Ahmed-Samy-Elsaiid/Mechanical-Absorber/README.md

# Mechanical-Absorber
Designing mechanical absorber to nullify the vibration in the system.
