Ahmed-Samy-Elsaiid/Mechanical-Absorber/MV Project Final.pdf

# REPORT

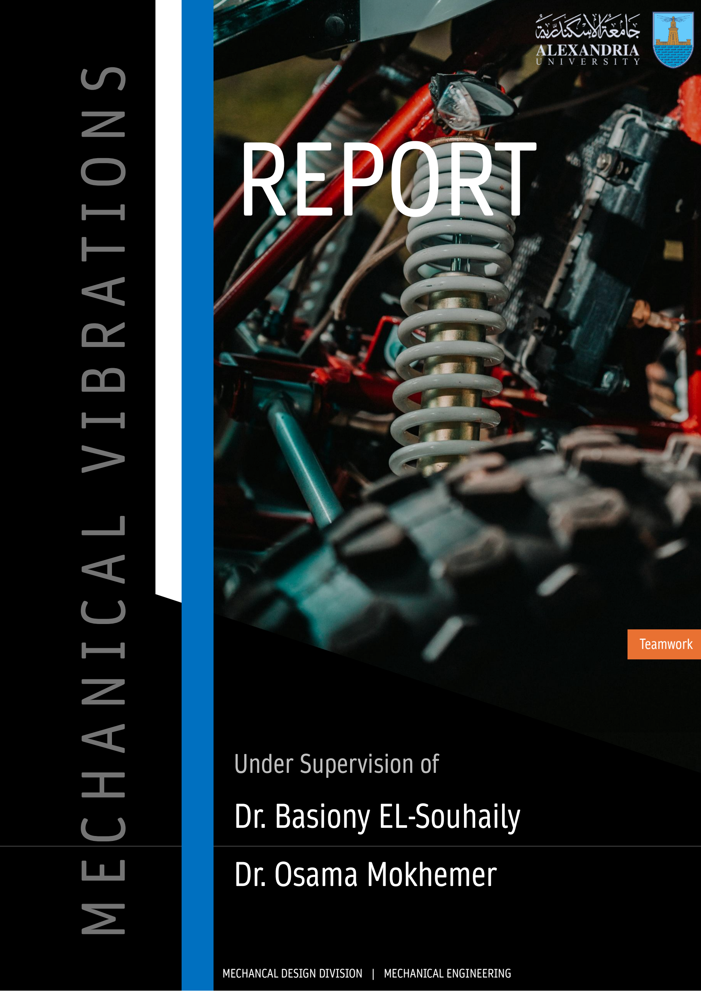
[picture p1: page 1]

## Under Supervision of

# Dr. Basiony EL

# -Souhaily

# Dr. Osama Mokhemer

# M E C H A N I C A L V I B R A T I O N S

MECHANCAL DESIGN DIVISION | MECHANICAL ENGINEERING

Teamwork

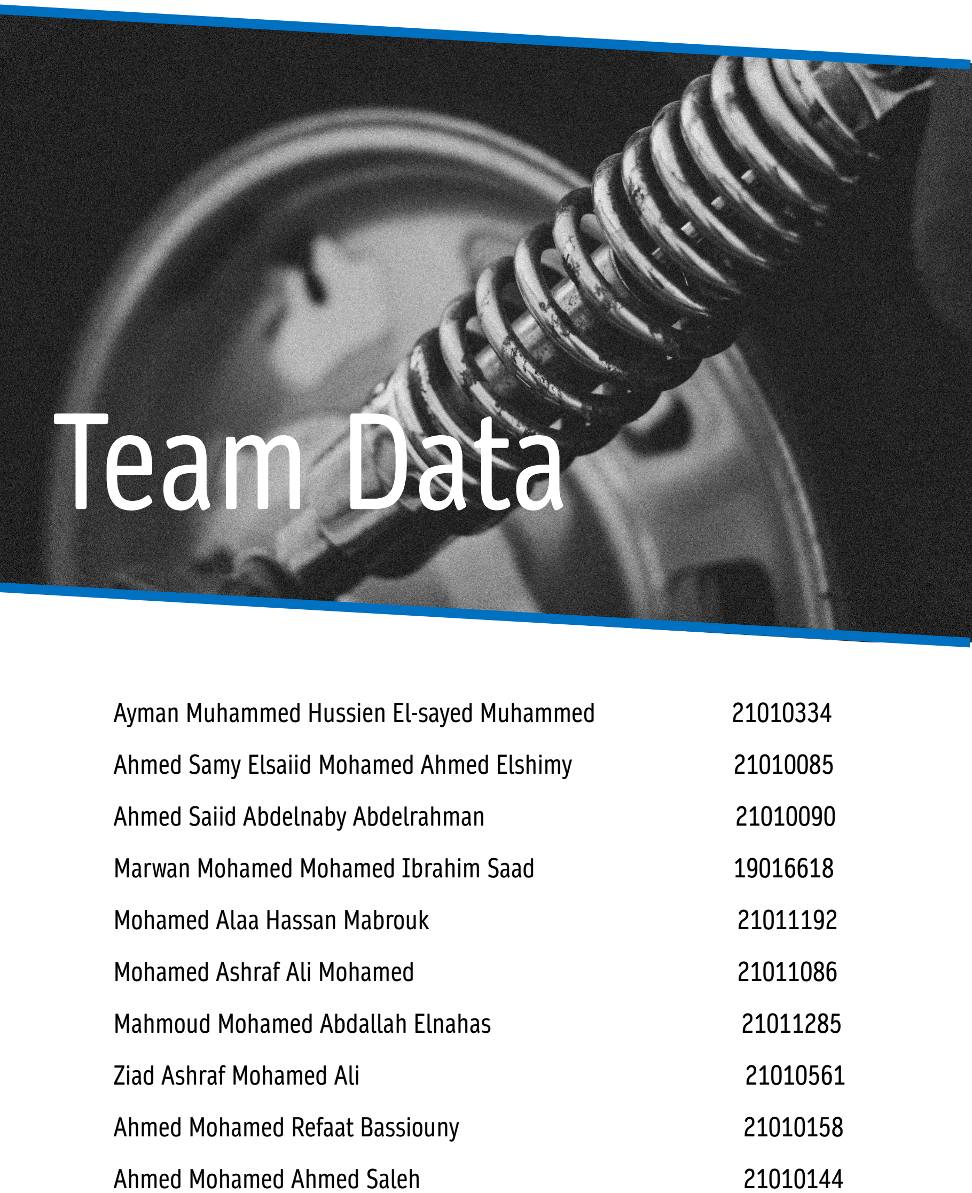
[picture p2: page 2]

Ayman Muhammed Hussien El-sayed Muhammed | 21010334
Ahmed Samy Elsaiid Mohamed Ahmed Elshimy | 21010085
Ahmed Saiid Abdelnaby Abdelrahman | 21010090
Marwan Mohamed Mohamed Ibrahim Saad | 19016618
Mohamed Alaa Hassan Mabrouk | 21011192
Mohamed Ashraf Ali Mohamed | 21011086
Mahmoud Mohamed Abdallah Elnahas | 21011285
Ziad Ashraf Mohamed Ali | 21010561
Ahmed Mohamed Refaat Bassiouny | 21010158
Ahmed Mohamed Ahmed Saleh | 21010144

# Team Data

Report

Mechanical Department | Mechanical Desing Division | 1

## Rotating Unbalance Project

## Abstract

Mechanical vibration plays a critical role in the design, maintenance, and performance of rotating machinery. This report investigates the phenomenon of rotating unbalance, a primary source of mechanical vibration in rotating systems. The experimental project conducted focuses on analyzing the dynamics of rotating unbalance and its effects on system stability and performance. Using experimental setups, the study quantifies the relationship between rotational speed, unbalance magnitude, and vibration amplitude. The findings underscore the importance of identifying and mitigating rotating unbalance to improve the reliability of mechanical systems. Practical insights and recommendations are provided to aid in diagnosing and reducing vibration in real-world applications.

Rotating Unbalance, Harmonic, Frequency, dynamics

## Introduction

Rotating machinery is ubiquitous in industries ranging from automotive to aerospace and manufacturing. Despite its essential role, such machinery is often prone to mechanical vibrations, which can lead to increased wear, fatigue, and eventual failure of components. Among the various causes of mechanical vibration, rotating unbalance is one of the most common and critical issues.

Rotating unbalance occurs when the mass distribution of a rotating component is not uniform around its axis of rotation. This imbalance generates centrifugal forces that induce vibrations in the system, particularly at high rotational speeds. Left unaddressed, these vibrations can compromise the efficiency and safety of the equipment.

The subsequent sections of this report detail the experimental setup, data collection methods, analysis, and findings. The report concludes with a discussion of the implications of rotating unbalance and recommendations for practical applications.

The phenomenon of mechanical vibrations often poses significant challenges in engineering systems, especially in rotating machinery such as pumps. These vibrations, arising from periodic excitation forces like unbalanced masses, can lead to performance inefficiencies, structural damage, and even system failure. To mitigate these issues, dynamic vibration absorbers are employed. These devices are carefully designed to counteract the vibrations by introducing a secondary mass-spring system tuned to the excitation frequency.

This project focuses on the simulation and analysis of a vibrating pump mounted on a hinged-hinged beam with a square cross-section. The pump experiences periodic excitation forces due to its rotating unbalance. A dynamic vibration absorber is attached beneath the pump to mitigate these vibrations. By analyzing the vibration response of the system with and without the absorber, as well as using absorbers with varying masses, this study aims to understand the optimal conditions for vibration suppression. Simulink is employed to model the system and simulate its behavior under different conditions.

## Design Requirements

Problem Understanding

- understanding of the vibrating pump and the effect of periodic excitation forces on the hinged-hinged beam.
- Study the working principle of dynamic absorbers and their role in mitigating vibrations.
Mathematical Modeling
- The first critical step in the project is to construct an accurate mathematical model of the system.
- The model should incorporate the primary mass (m1), the absorber mass (m2),.the stiffness constants (k_1 and〖 k〗_2), and the vibration amplitudes (x_1 (t) and x_2
(t) as depicted in the provided schematic

Simulink Model Development

- Using the derived mathematical equations, develop a Simulink model to simulate the system’s dynamic response.
- Validate the model by comparing theoretical predictions with simulation results. Parameter Variation
- Analyze the effect of varying the absorber mass (m2) to 50%, 100%, and 150% of the optimal absorber mass.
- Simulate the system response for each case and determine the absorber’s effectiveness in reducing vibrations.

Practical Implementation

After achieving a reliable simulation model, plan for practical solutions or experimental validation.

Ensure the practicality of absorber design for real-world applications.
Performance Evaluation
- Evaluate the vibration suppression performance by comparing the system’s response before and after the installation of the dynamic absorber.
- Optimize the system for minimal vibrations under periodic excitation

## Mathematical Model

m1x1̈ + c1x1̇ + k1x1 + k2

(x1 − x2

) = Fsin(ωt)

m2x2

̈ + k2

(x2 − x1

) = 0

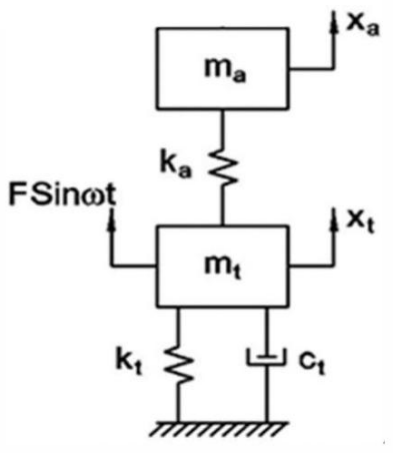
[picture p3: figure]

Where:

m1 : mass of the system.
m2 : mass of the absorber. k1 : stiffness of the system.
k2 : stiffness of the absorber.
c1 : damping of the system.
x1 : displacement of the system. x2 : displacement of the absorber. x1̇ : velocity of the system.
x1̈ : acceleration of the system. x2̈ : acceleration of the absorber.

## Calculations

From design requirements the pump is vibrating on a beam and the cross section of the beam is square. So, we chose the material to be AISI 304 with cross section 1cm × 1 cm and a thickness of 1 mm

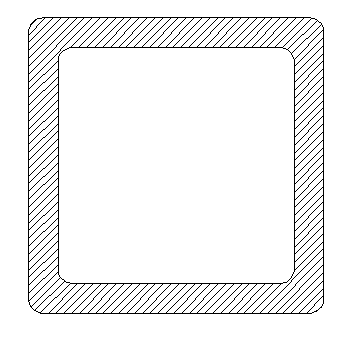
[picture p4: figure]

Beam properties

- E = 200 GPA
- Sy = 205 GPA
- Density = 8000 kg/m³

Beam stiffness calculations

kbeam =

48EI
L

3

I =

b

4 − (b − 2t)

4
12

Where

- L is the beam length
- b is the square beam side length
- E is the modulus of elasticity
- I is the second moment of inertia
- t is the thickness of the square beam
- The beam material is Stainless steel AISI 304 with elastic modulus of 193GPA

I =

0.01⁴ − (0.01 − 2 ∗ 0.001)

4
12 | = 4.95 ∗ 10⁻¹⁰

kbeam =

48 ∗ 200 ∗ 10⁹

∗ 4.95 ∗ 10⁻¹⁰
0.5
3 | = 37.78 kN/m

Absorber stiffness calculations

Mass of the system (m1

) = 550 gram

Natural frequency of the system = √
kbeam
m1

= √
37780
0.55

= 262.1 rad/s

- ωs = 262.1 rad/s = 2502.95 RPM
- ω = 2500 RPM = 261.8 rad/s
- So, the system is approximately at resonance.
- To minimize the resonance ωa should be equal to ω.
- To more safety m2 ≈

m1
2

≈ 250 gram

k2 = m2 ∗ ωa

2 = 0.25 ∗ 261.8

2 = 17.13 kN/m

k2 =

Gd
8NC

3

Where

- C is the spring index
- d is the coil wire diameter
- N is the number of active coils
- G is the modulus of rigidity

Assumptions
- C = 5
- d = 2 mm

N =

Gd
8k2C

3 =

80 ∗ 10⁹
∗ 0.002
8 ∗ 17130 ∗ 5

3 = 9.33 ≈ 10

k2 =

Gd
8NC

3 =

80 ∗ 10⁹
∗ 0.002
8 ∗ 10 ∗ 5

3 = 16 kN/m

ωs = √
k2
m2

= √
16000
0.25

= 252.98 rad/s = 2415.8 RPM

## Fabrication and Manufacturing

After the design was finalized and thoroughly reviewed multiple times to ensure all design requirements were successfully met, a bill of materials (BOM) for the entire assembly was created (as shown in table 1 ).

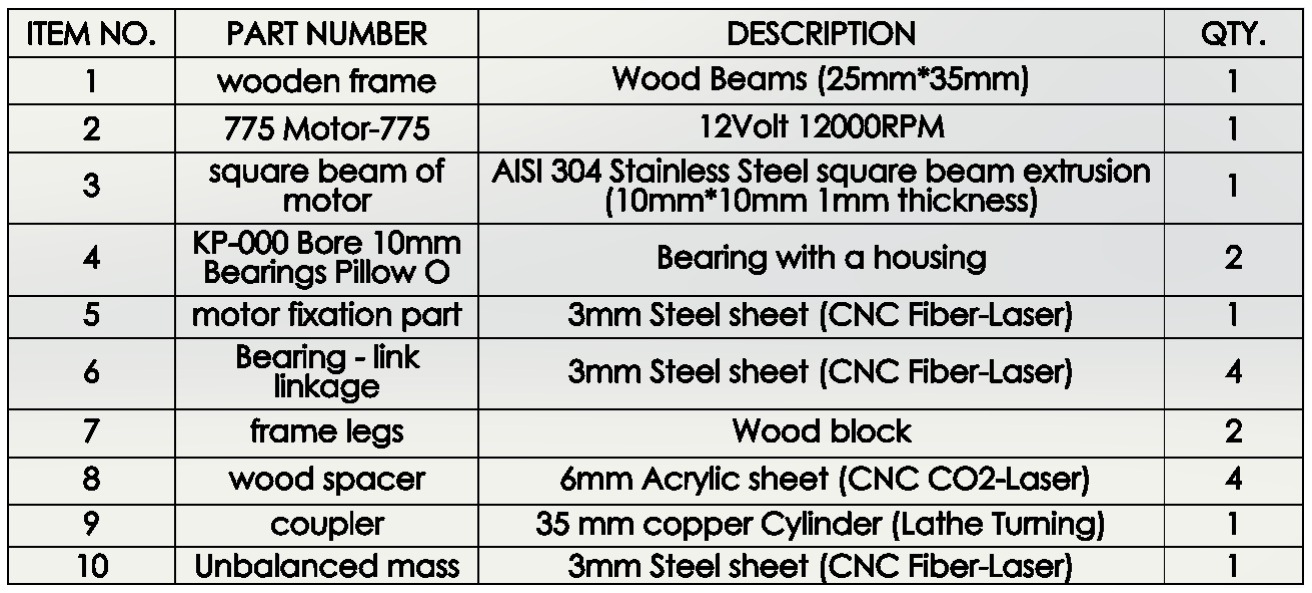
[picture p5: figure]

The BOM was prepared to:

1. List the quantity of each required part.
2. Specify the various raw materials needed.
3. Outline the fabrication and manufacturing process for each part.

Raw material:

- 3mm Steel sheets (180mm*120mm)
- 6mm Acrylic Sheets (55mm*55mm)
- 10mm*10mm AISI 304 Square Extrusion 1mm thickness
- 35mm Copper Bars
- Wood Bars (25mm*35mm)
Table 1 | Bill of Material

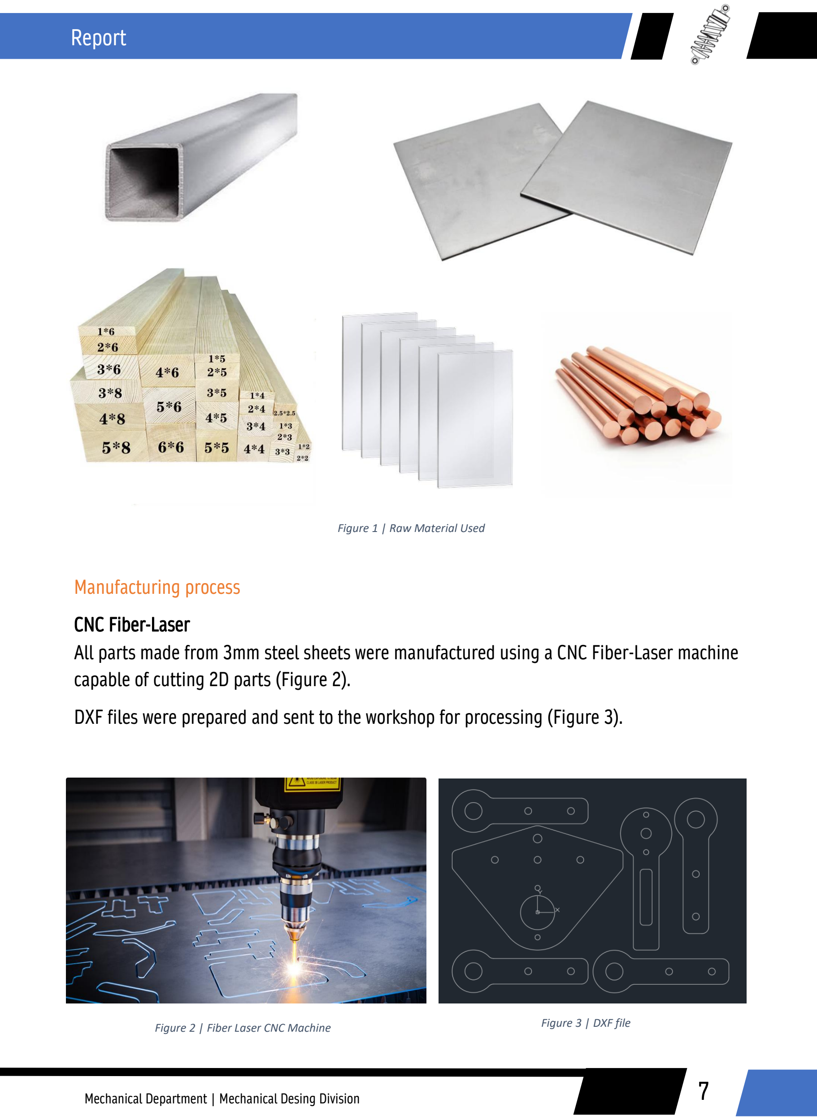
[picture p6: page 9]

Manufacturing process

CNC Fiber-Laser
All parts made from 3mm steel sheets were manufactured using a CNC Fiber-Laser machine capable of cutting 2D parts (Figure 2).

DXF files were prepared and sent to the workshop for processing (Figure 3).

Figure 1 | Raw Material Used
Figure 2 | Fiber Laser CNC Machine | Figure 3 | DXF file

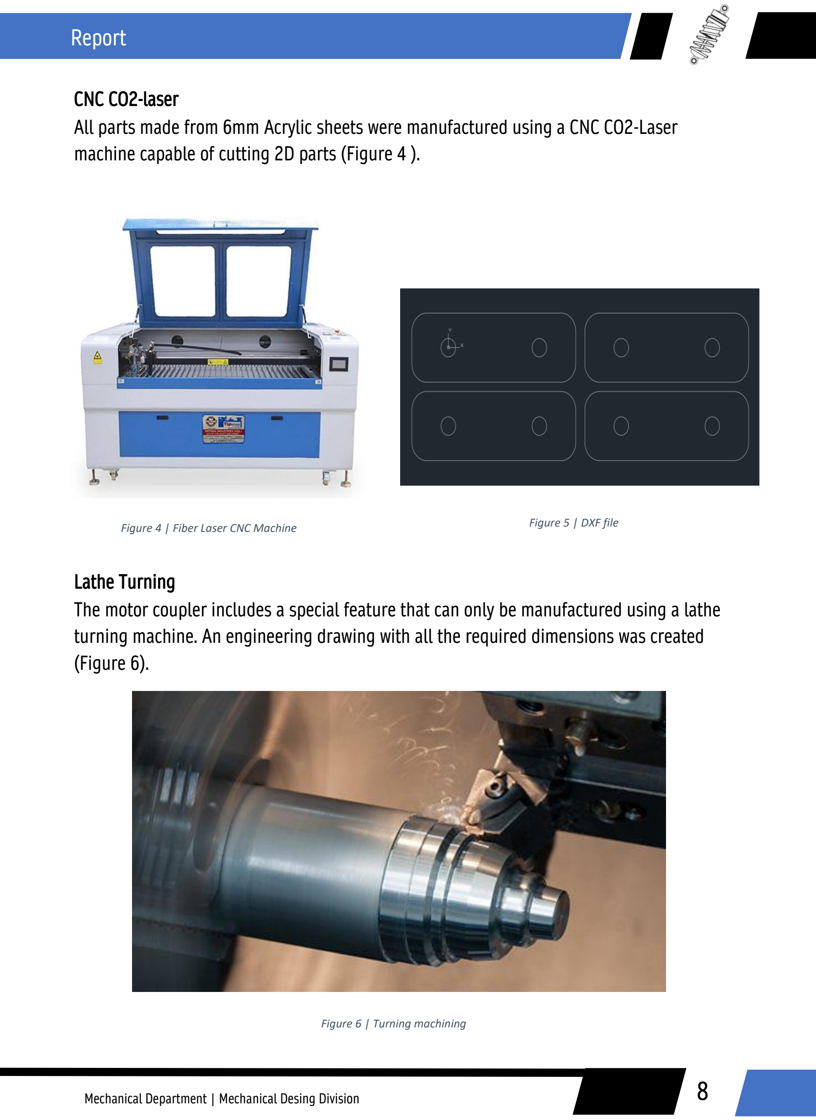
[picture p7: page 10]

CNC CO2-laser
All parts made from 6mm Acrylic sheets were manufactured using a CNC CO2-Laser machine capable of cutting 2D parts (Figure 4 ).

Lathe Turning
The motor coupler includes a special feature that can only be manufactured using a lathe turning machine. An engineering drawing with all the required dimensions was created (Figure 6).
Figure 4 | Fiber Laser CNC Machine | Figure 5 | DXF file
Figure 6 | Turning machining

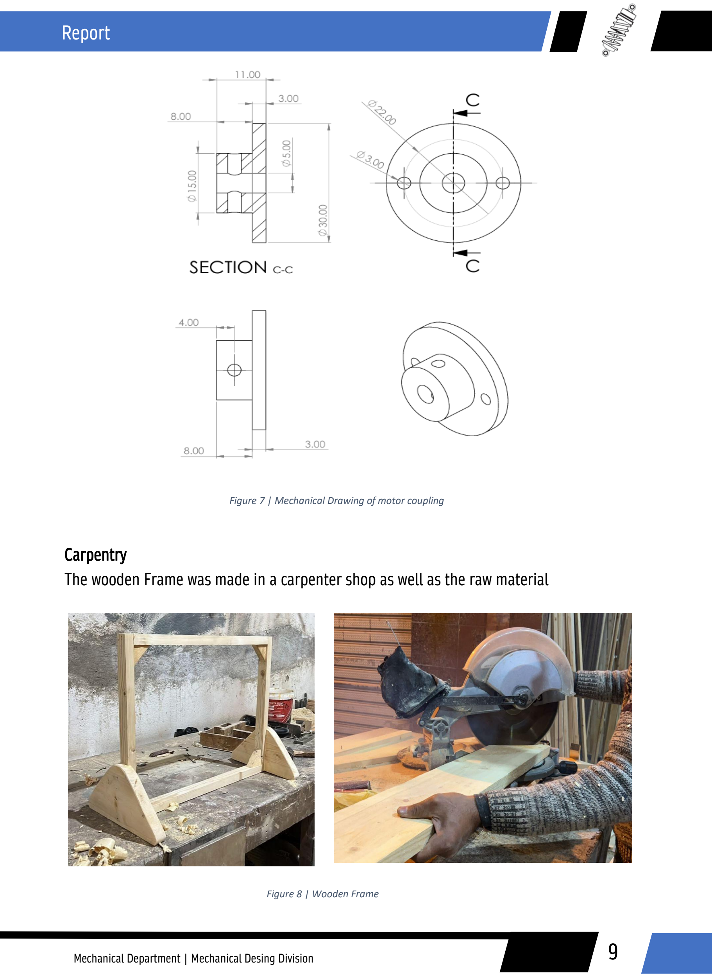
[picture p8: page 11]

Carpentry
The wooden Frame was made in a carpenter shop as well as the raw material
Figure 7 | Mechanical Drawing of motor coupling
Figure 8 | Wooden Frame

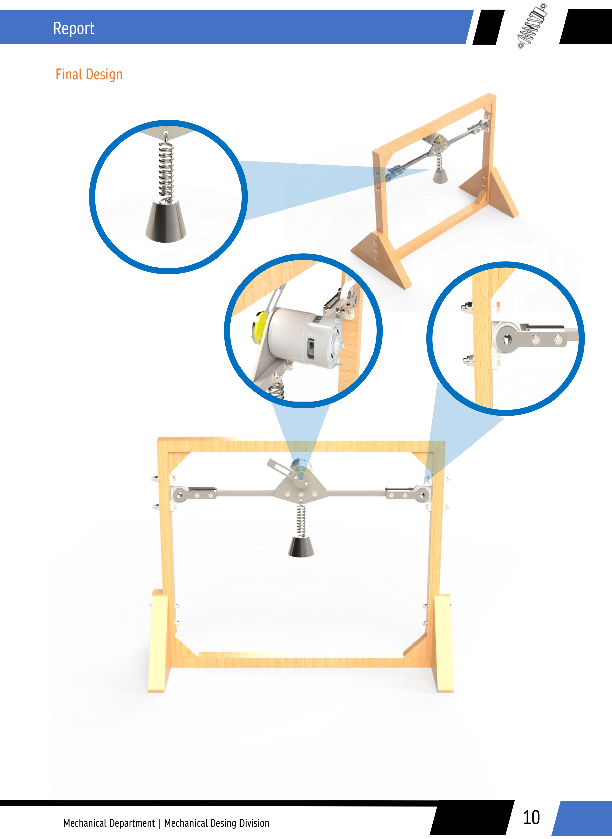
[picture p9: page 12]

Final Design

Controlling Motor’s speed

Why controlling motor’s speed
Prevent Overloading
- Running the motor at full speed continuously may draw excessive current, potentially overheating or damaging the motor.
- With velocity control, the motor operates within safe limits.

Energy Efficiency

- Full-speed operation consumes maximum energy, even if the application doesn't need it.
- Controlling velocity optimizes power usage and prolongs battery life.

Smooth Operation

- Direct connection to a battery causes sudden starts and stops, leading to mechanical stress on the motor and connected systems.
- PWM control provides smooth acceleration and deceleration.

Programmable Control

- With an Arduino, you can program the motor to operate in response to specific inputs or conditions (e.g., sensors, timers).
- This makes the system adaptable and intelligent, unlike a static direct connection to a battery.

Safety:

- Sudden or uncontrolled motor movements can be dangerous in systems with moving parts.
- Controlled velocity reduces the risk of accidents and allows for emergency stopping.

Protection of Components:

- A sudden surge of power when connecting directly to a battery can damage sensitive mechanical or electronic components.
- Motor drivers and PWM signals regulate power delivery, ensuring safe operation.

How to control the motor’s speed:

Controlling Motor Speed Using Microcontroller:

Components Used:

- Arduino UNO
- Cytron Dual Channel 10A DC (5-30 V) MDD10A
- DC Motor
- Potentiometer
- Breadboard and Jumper Wires
- 12V Battery for Power Supply

Working Principle:

- The potentiometer is used as an analog input device to control the speed of the motor.
- The Arduino reads the voltage from the potentiometer and maps it to a PWM (Pulse Width Modulation) signal.
- This PWM signal is sent to the motor driver, which adjusts the motor's speed accordingly.

WHY USE THE MDD10A Instead of L298N?

- Higher Current Capability: Handles up to 10A continuous current per channel, suitable for high-power motors.
- Wide Voltage Range: Supports motors operating at 5V to 30V, making it versatile for various applications.
- Efficient MOSFET-Based Design: Generates less heat compared to the L298N's transistor-based design.
- Simpler Connections: Directly compatible with PWM signals from microcontrollers like Arduino.
- Direction and Speed Control: Provides precise motor control with separate inputs for speed (PWM) and direction.

Connection Details

3.1. Potentiometer to Arduino:
- Purpose: The potentiometer is used as an input to adjust the motor speed.
- Connections:
- One outer pin of the potentiometer → 5V on Arduino.
- Other outer pin of the potentiometer → GND on Arduino.
- Middle pin (wiper) of the potentiometer → A0 (Analog Pin 0) on Arduino.
3.2. Cytron MDD10A Motor Driver to Arduino:
- Purpose: The motor driver controls the motor's speed and direction using signals from the Arduino.
- Connections for Motor Channel 1 (Single Motor Setup):
- PWM1 on MDD10A → Pin 10 (PWM-capable pin) on Arduino (for speed control).
- DIR1 on MDD10A → Pin 9 on Arduino (for direction control).
- GND on MDD10A → GND on Arduino (common ground is essential for proper operation).

3.3. Cytron MDD10A to Motor:
- Purpose: The motor driver delivers power to the motor and regulates its operation.
- Connections:
- M1+ on MDD10A → Positive terminal of the DC motor.
- M1- on MDD10A → Negative terminal of the DC motor.
3.4. Cytron MDD10A to Power Source (12V Battery)
- Purpose: Supplies power to the motor via the motor driver.
- Connections:
- VM (Voltage Motor) on MDD10A → Positive terminal of the 12V battery.
- GND on MDD10A → Negative terminal of the 12V battery.
3.5. Powering the Arduino

Use the Arduino's USB cable for power during testing (connect to a computer or USB power source).

Code Implementation

| int in2 = 9;
int ConA = 10; // Don't forget this is a PWM DI/DO int speed1;

void setup() {
pinMode(9, OUTPUT); //Direction Control pinMode(10, OUTPUT); //PWM Serial.begin(9600);
delay(50);
}
void TurnMotorA(){ | //We create a function which control the direction
and speed //Switch between this HIGH and LOW to change direction digitalWrite(in2, HIGH);
speed1 = analogRead(A1);
speed1 = map(speed1, 0, 1023, 0, 255);
Serial.println(speed1);
analogWrite(ConA,speed1); // Then inject it to our motor }

void loop() {
TurnMotorA(); | //one function that keeps looping you can add
another one with different direction or stop
}

Explanation of Code

5.1. Pin Setup:
- int in2 = 9;: Pin 9 controls the direction of the motor.
- int ConA = 10;: Pin 10 sends a PWM signal to control the motor's speed.
- int speed1;: Variable to store the motor's speed value (calculated from the potentiometer).

—-------—---------------------------------------

5.2. setup() Function:
- pinMode(9, OUTPUT);: Sets pin 9 as an output for direction control.
- pinMode(10, OUTPUT);: Sets pin 10 as an output for speed control (PWM).
- Serial.begin(9600);: Starts the Serial Monitor for debugging.
- delay(50);: Adds a small delay.

—-------—---------------------------------------

5.3. TurnMotorA() Function:

This function does the actual work of controlling the motor:

A. Set Motor Direction:
- digitalWrite(in2, HIGH);: Sets the motor's direction to forward.
- (To reverse direction, you can set this to LOW later.)
B. Read Potentiometer Value:
- speed1 = analogRead(A1);: Reads the position of the potentiometer from pin A1. The value ranges from 0 to 1023.
C. Map Potentiometer Value to Motor Speed:
- speed1 = map(speed1, 0, 1023, 0, 255);: Converts the potentiometer's value (0-1023) to a PWM value (0-255). This makes the motor speed proportional to the potentiometer position.

D.Send Speed to Motor:

- analogWrite(ConA, speed1);: Sends the calculated PWM value to pin 10 to control the motor's speed.

E.Debugging:

- Serial.println(speed1);: Prints the motor speed to the Serial Monitor for monitoring.

—-------—---------------------------------------

5.4. loop() Function
- TurnMotorA();: Keeps calling the TurnMotorA() function in an infinite loop to continuously adjust the motor speed and direction based on the potentiometer's position.

—-------—---------------------------------------

How It Works

1. The potentiometer is read to determine the motor's speed.
2. The speed is mapped to a value the motor driver can use (0-255).
3. The motor direction is set to forward (by default in this code).
4. The speed is sent to the motor driver via PWM on pin 10.

Key Notes

- Direction Control: This code currently only supports one direction (HIGH). To change direction, modify digitalWrite(in2, HIGH); to LOW or create another function for reverse direction.
- Speed Control: The potentiometer adjusts the motor speed smoothly.
- Serial Monitor: You can monitor the speed values (0-255) in the Arduino Serial Monitor.

Conclusion

By controlling the motor's velocity with a driver and an Arduino, you gain precise control, efficiency, and versatility, while protecting the motor and other components. Directly connecting a motor to a 12V battery is only suitable for simple systems that don’t require speed regulation, direction control, or programmable behavior.

## Results

System parameters

- Unbalance mass = 30 gram
- eccentricity of unbalanced mass = 2 cm
- velocity of motor = 2500 RPM
- Mass of tℎe system = 550 gram
- Mass of tℎe absorber = 250 gram

Assumptions
1. Tℎe system ℎas no damping
2. Tℎe system ℎas damping coefficient of 0.05

MATLAB Code

1. % System parameters
2. clc;clear,clf;
3. m = 0.03; % unbalanced mass
4. e = 0.02; % eccentricity of unbalanced mass
5. w =2500*2*pi/60 ; % angular velocity of motor (rad/sec)
6. F_amp = m*e*w^2 ; % Amplitude of the excitation force (N)
7. m1 = 0.55; % Mass of the pump (kg)
8. m2 = 0.125*2; % Mass of the absorber (kg)
9. k1 = 38000; % Stiffness of the pump (N/m)
10. k2 = 17000; % Stiffness of the absorber (N/m)
11. w_n = (k1/m1)^0.5; % natural frequency of the system
12. w_a = (k2/m2)^0.5; % natural frequency of the absorber
13. zeta=0.0; % damping factor
14. c_1=zeta*2*m1*w_n; % damping coeffecient
15. a=(k1+k2)/m1;b=-k2/m1;c=-k2/m2;d=k2/m2;e=a+d;f=a*d-b*c;
16. w_n1=((e-(e^2-4*f)^0.5)/2)^0.5;
17. w_n2=((e+(e^2-4*f)^0.5)/2)^0.5;
18. a1=(a-w_n1^2)/-b;
19. b1=(a-w_n2^2)/-b;
20. x_1=((k2-w^2*m2)*F_amp)/((k1+k2-w^2*m1)*(k2-w^2*m2)-k2^2);
21. x_2=(k2*F_amp)/((k1+k2-w^2*m1)*(k2-w^2*m2)-k2^2);
22. B2=((x_2-a1*x_1)*w)/((b1-a1)*w_n2);
23. B1=-(x_1*w+B2*w_n2)/w_n1;
24. r=w/(k1/m1)^0.5;

25. x_st=F_amp/k1;
26. x_o=(x_st)/((1-r^2)^2+(2*r*zeta)^2)^0.5;
27. if zeta==0
28. t=0:0.0001:6;
29. if r==0
a. x=x_st/2*w_n*t;
30. else
a. x=x_o*(sin(w*t)-r*sin(w_n*t));
31. end
32. x1=x_1*(sin(w*t))+B1*sin(w_n1*t)+B2*sin(w_n2*t);
33. x2=x_2*(sin(w*t))+a1*B1*sin(w_n1*t)+b1*B2*sin(w_n2*t);
34. figure(1)
35. plot(t,x)
36. grid on
37. xlabel('time (sec)');
38. ylabel('amplitude (m)');
39. title('Machine Response without absorber' );
40. figure(2)
41. plot(t,x1)
42. grid on
43. xlabel('time (sec)');
44. ylabel('amplitude (m)');
45. title('Machine Response with absorber' );
46. figure(3)
47. plot(t,x2)
48. grid on
49. xlabel('time (sec)');
50. ylabel('amplitude (m)');
51. title('Response of absorber' );
52. elseif zeta<0
53. t=0:0.0001:0.2;
54. fprintf("wrong value for zeta")
55. elseif zeta~=0
56. t=0:0.0001:0.2;
57. x=x_o*(sin(w*t));
58. x1=x_1*(sin(w*t));
59. x2=x_2*(sin(w*t));
60. figure(1)
61. plot(t,x)
62. grid on
63. xlabel('time (sec)');
64. ylabel('amplitude (m)');
65. title('Machine Response without absorber' );
66. figure(2)
67. plot(t,x1)
68. grid on
69. xlabel('time (sec)');
70. ylabel('amplitude (m)');
71. title('Machine Response with absorber' );
72. figure(3)

73. plot(t,x2)
74. grid on
75. xlabel('time (sec)');
76. ylabel('amplitude (m)');
77. title('Response of absorber' );
78. end
79. % Constants
80. ws = sqrt(k1 / m1); % Natural frequency of the main system (rad/s)
81. % Mass ratios to analyze
82. w_wa = linspace(0, 2, 100000); % Frequency ratio (w/wa)
83. % Set up the figure
84. % Parameters for each mass ratio
85. m2 = 0.125*2; | % Mass of absorber
86. k2 = 17000; | % Stiffness of the absorber (N/m)
87. wa = sqrt(k2 / m2); | % Absorber natural frequency (rad/s)
88. % Machine response: X1/Xst
89. X1_Xst = abs((1 - (w_wa).^2) ./ ...
i. ((1 + k2/k1 - (w_wa * ws / wa).^2) .* ... ii. (1 - (w_wa).^2) - k2/k1));
90. % Absorber response: X2/Xst
91. X2_Xst = abs(1 ./ ...
i. ((1 + k2/k1 - (w_wa * ws / wa).^2) .* ... ii. (1 - (w_wa).^2) - k2/k1));
92. % Plot machine response
93. figure(4)
94. subplot(1, 2,1);
95. plot(w_wa, X1_Xst, 'r', 'LineWidth', 1.5);
96. xlabel('Frequency ratio (\omega / \omega_a)');
97. ylabel('abs(X_1 / X_{st})');
98. title('Machine Response' );
99. grid on;
100. axis([0 2 0 20]);
101. % Plot absorber response
102. subplot(1, 2,2);
103. plot(w_wa, X2_Xst, 'b', 'LineWidth', 1.5);
104. xlabel('Frequency ratio (\omega / \omega_a)');
105. ylabel('abs(X_2 / X_{st})');
106. title('Absorber Response' );
107. grid on;
108. axis([0 2 0 20]);
109. Reg_1=abs((w-w_n1)/w*100);
110. Reg_2=abs((w-w_n2)/w*100);
111. reg=[Reg_1 Reg_2];
112. fprintf("\nThe natural frequencies is at least : \n +- %f %% from the operating speed\n",min(reg))

Explaining of code

- 1~14 ∶ System parameters and basic calculations.
- 15~17 : calculations of natural frequencies of the two-degree system.
- 18~26 : calculating the amplitudes of the response before and after the absorber.
- 27~78 : if condition to plot the response in case of damped and not damped system.
- 79~108 : plotting the effect of the ratio of frequency of the motor to the natural frequency of the absorber on the amplitude of the system and the absorber.
- 109~112 : calculating of percentage of the speed range according to working speed.

## Results from MATLAB

1. Damped system
- Response of the system before adding the absorber:

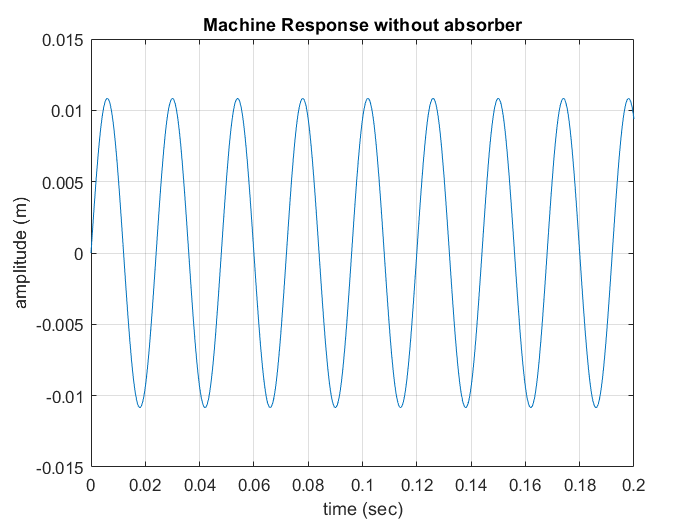
[picture p10: figure]
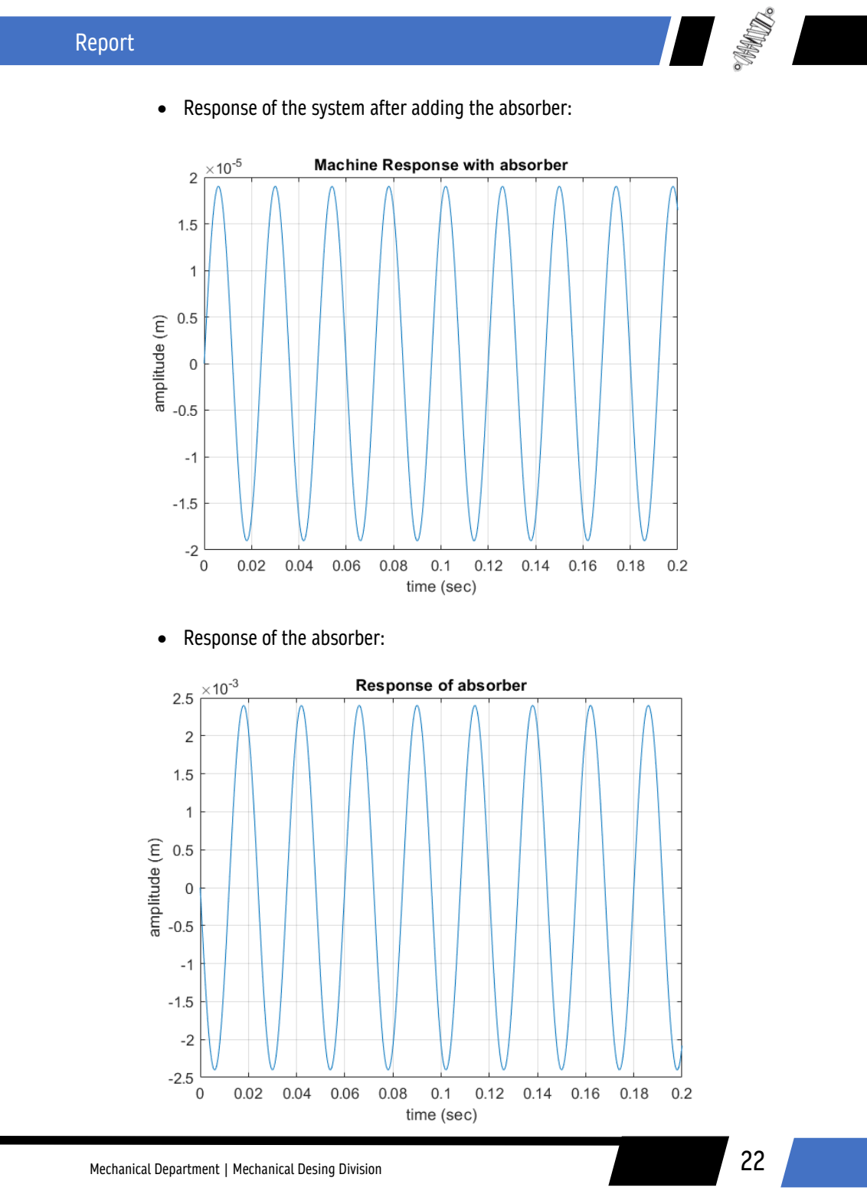
[picture p11: page 24]

- Response of the system after adding the absorber:
- Response of the absorber:

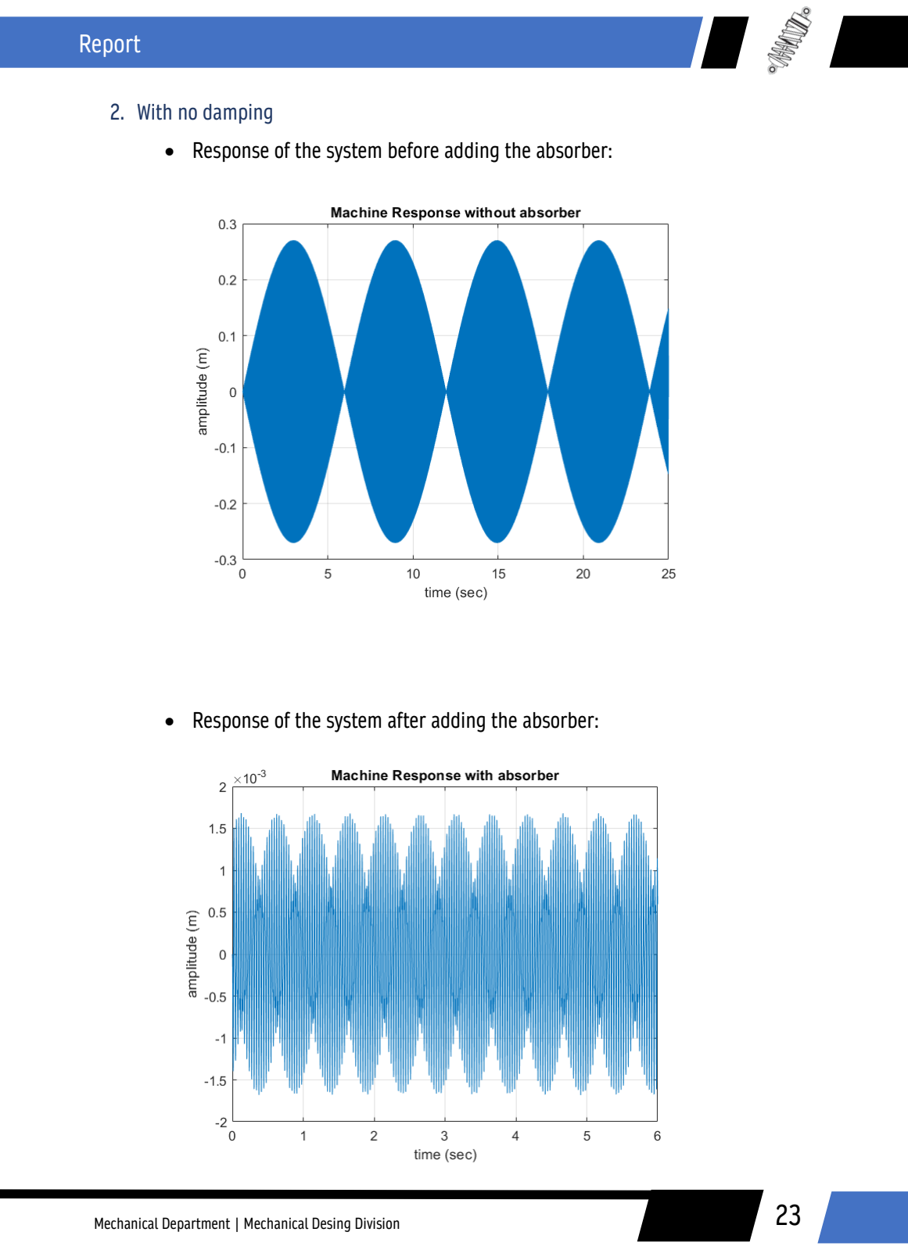
[picture p12: page 25]

2. With no damping
- Response of the system before adding the absorber:
- Response of the system after adding the absorber:

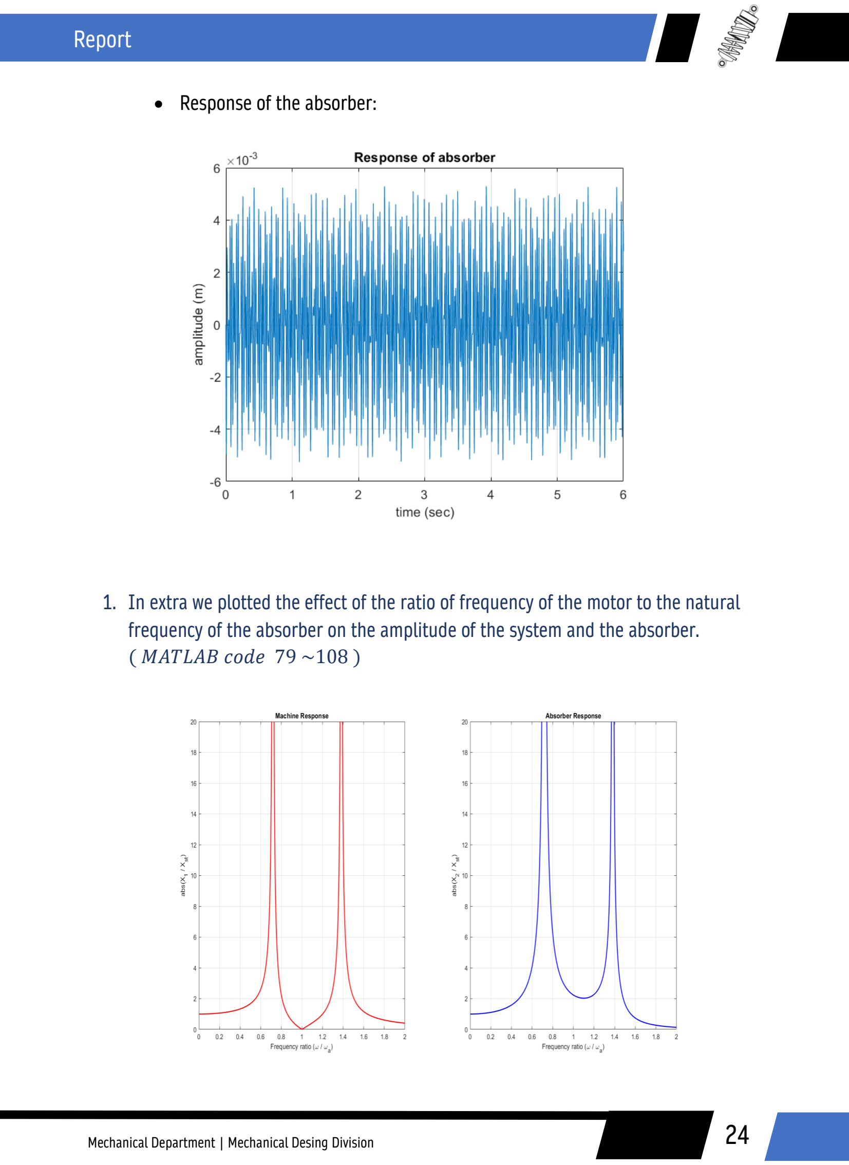
[picture p13: page 26]

- Response of the absorber:
1. In extra we plotted the effect of the ratio of frequency of the motor to the natural frequency of the absorber on the amplitude of the system and the absorber.
( MATLAB code 79 ~108 )

2. In extra we calculated of percentage of the speed range according to working speed. ( MATLAB code 109~112 )
- Tℎe natural frequencies is at least ∶
± 28.089163 % from tℎe operating speed

Modeling using Simulink

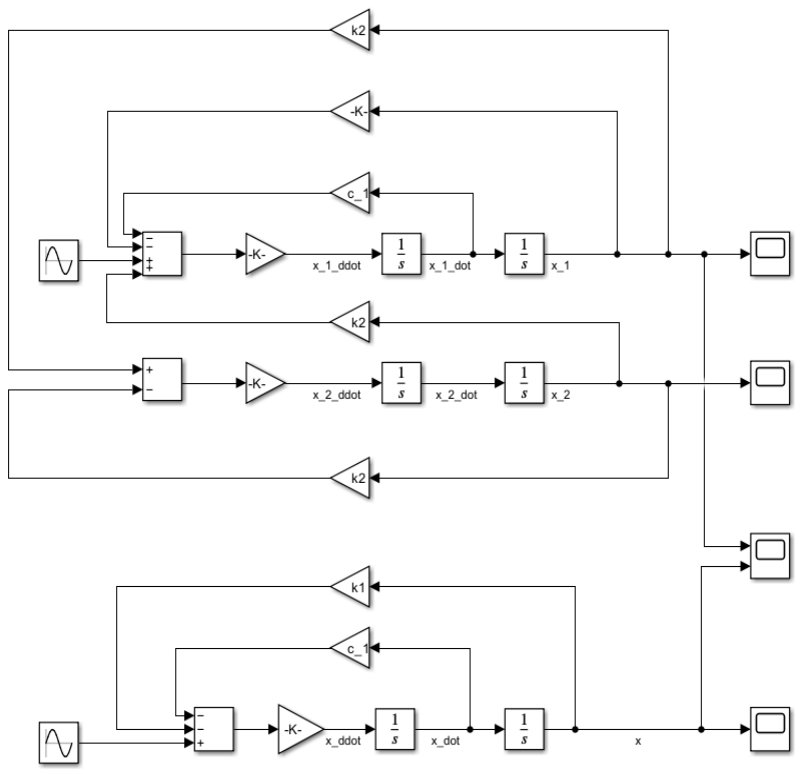
[picture p14: figure]

## Results from Simulink

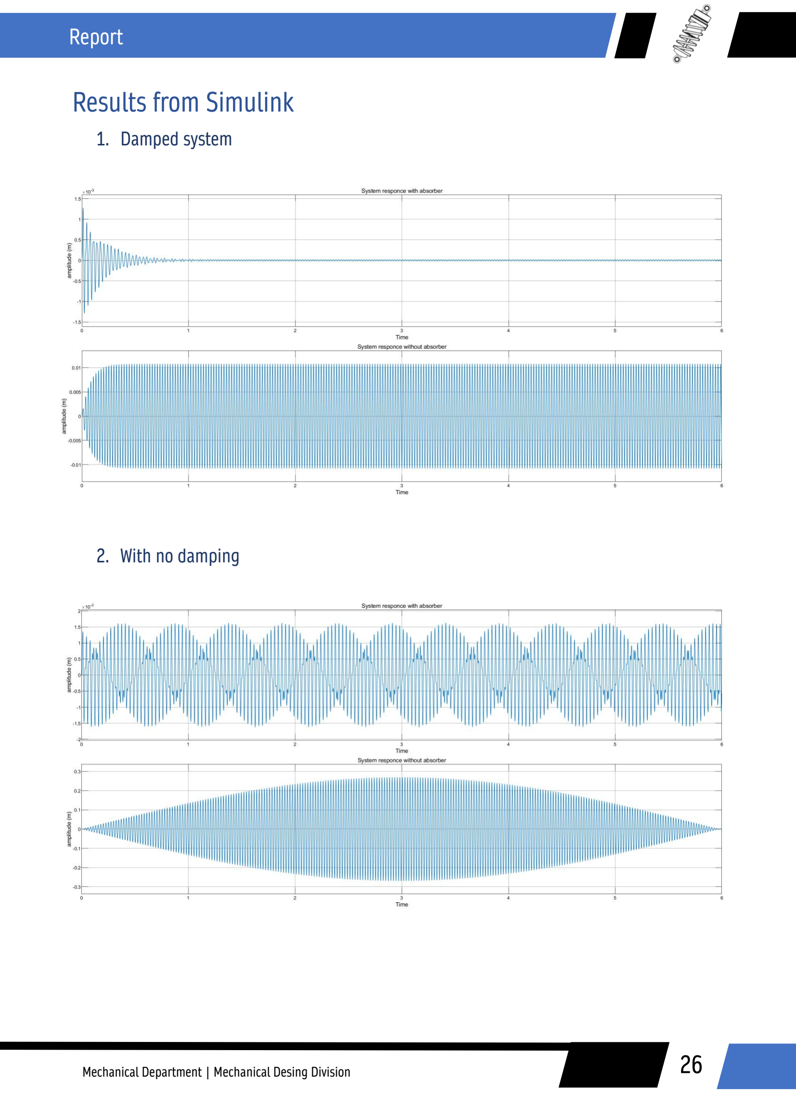
[picture p15: page 28]

1. Damped system
2. With no damping

## Conclusion

The system is experiencing rotational unbalance, resulting in excessive amplitude, which adversely affected its stability and performance. Such unbalances are common in rotating machinery and can lead to increased wear, noise, and potential failure if not addressed, the maximum amplitude was 10.83mm, we aim to reduce this maximum amplitude.

There are three methods to decrease this amplitude:
- Introducing damping into the system.
- Modifying the system’s mass and spring stiffness.
- Incorporating an auxiliary mass system.

The required method for amplitude reduction is an auxiliary mass system. This approach effectively countered the rotational unbalance, reducing the amplitude to a more acceptable level and thereby improving the system's overall stability. The auxiliary mass system worked by altering the dynamics of the system, thereby mitigating the forces caused by the unbalance.

The successful reduction of amplitude through this method highlights the importance of innovative solutions like the use of auxiliary masses to enhance the performance of mechanically rotating systems. By introducing the auxiliary mass, we were able to achieve a more controlled and efficient operation, reducing the risk of mechanical failure and increasing the longevity of the system. Additionally, this method offers a relatively simple and cost-effective way to address the problem of rotating unbalance.

To adapt the auxiliary mass system for this application, we utilized a spring with a stiffness of 17000 N/mm, a coil diameter of 2mm, a mean spring diameter of 10mm, and 10 coils. Additionally, the optimal mass for the auxiliary mass system is 250g, and we will use variable masses of 50%, 100% and 150%.

- With the 50% of the optimal mass, the maximum amplitude of the auxiliary mass system was 4.88mm, while the maximum amplitude of the system itself was 2.42mm. This resulted in a 77.65% reduction in the system's maximum amplitude.

- With the 100% of the optimal mass, the maximum amplitude of the auxiliary mass system was 2.399mm, while the maximum amplitude of the system itself was 0.019mm. This resulted in a 99.82% reduction in the system's maximum amplitude.
- With the 150% of the optimal mass, the maximum amplitude of the auxiliary mass system was 1.59mm, while the maximum amplitude of the system itself was 0.81409mm. This resulted in a 92.48% reduction in the system's maximum amplitude.

As observed in the previous points, the maximum amplitude of the system initially decreases and then increases, while the maximum amplitude of the auxiliary mass system continues to decrease.

In conclusion, the use of an auxiliary mass system proves to be an effective and practical solution for reducing amplitude caused by rotating unbalanced masses, offering a promising approach to improving system performance and durability.
