Ahmed-Samy-Elsaiid/Mechanical-Absorber/SolidWorks/Bearing - link linkage.SLDPRT

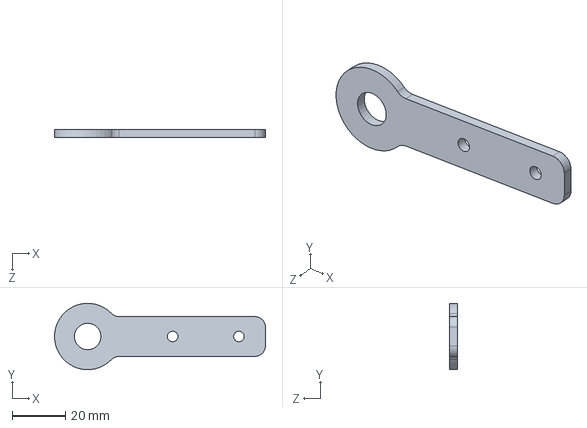
[picture p16: CAD file, 2025-02-14]
SolidWorks/Bearing - link linkage.SLDPRT
79.5 x 25.0 x 3.00 mm
