Ahmed-Samy-Elsaiid/Mechanical-Absorber/SolidWorks/motor fixation part.SLDPRT

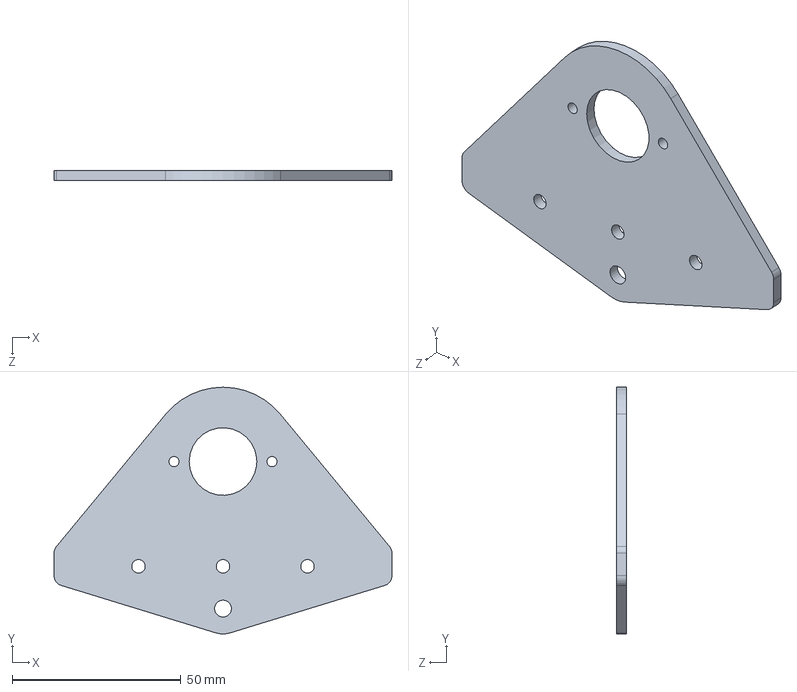
[picture p17: CAD file, 2025-02-14]
SolidWorks/motor fixation part.SLDPRT
100.0 x 73.0 x 3.00 mm
