Ahmed-Samy-Elsaiid/Mechanical-Absorber/SolidWorks/wooden frame.SLDPRT

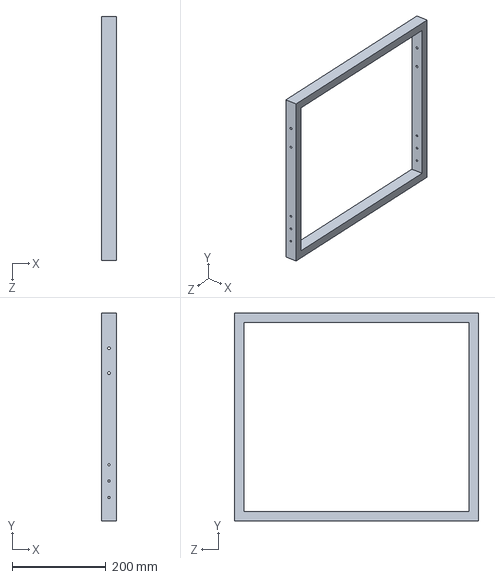
[picture p18: CAD file, 2025-02-14]
SolidWorks/wooden frame.SLDPRT
32.0 x 443.0 x 520.0 mm
