Ahmed-Samy-Elsaiid/Mechanical-Absorber/SolidWorks/wood spacer.SLDPRT

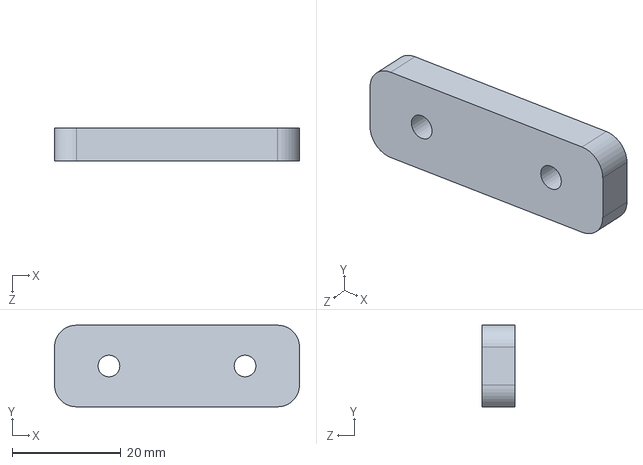
[picture p19: CAD file, 2025-02-14]
SolidWorks/wood spacer.SLDPRT
45.0 x 15.0 x 6.00 mm
