Ahmed-Samy-Elsaiid/Mechanical-Absorber/SolidWorks/square beam of motor.SLDPRT

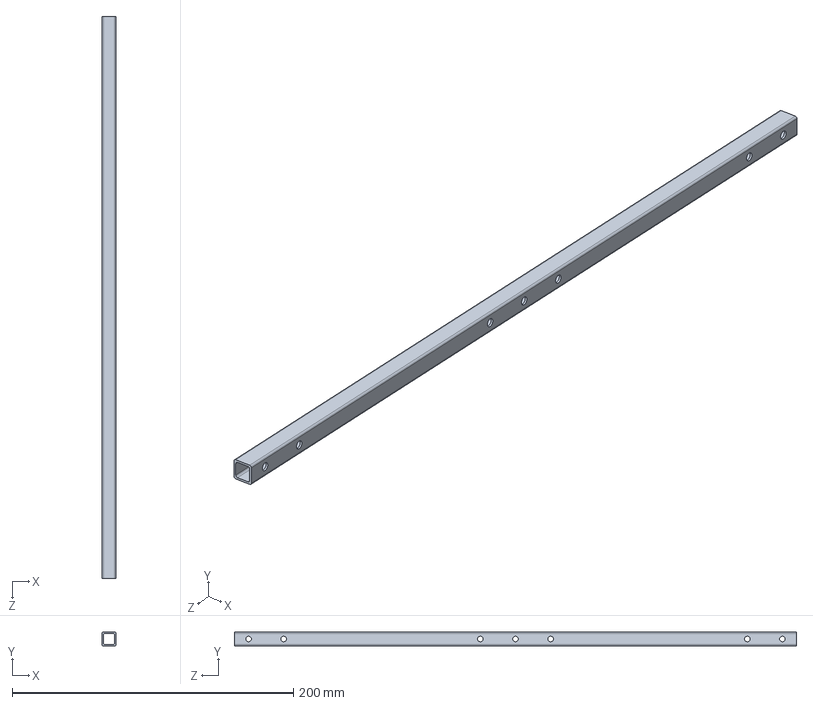
[picture p20: CAD file, 2025-02-14]
SolidWorks/square beam of motor.SLDPRT
10.0 x 10.0 x 400.0 mm
