Ahmed-Samy-Elsaiid/Mechanical-Absorber/SolidWorks/KP-000 Bore 10mm Bearings Pillow.STEP

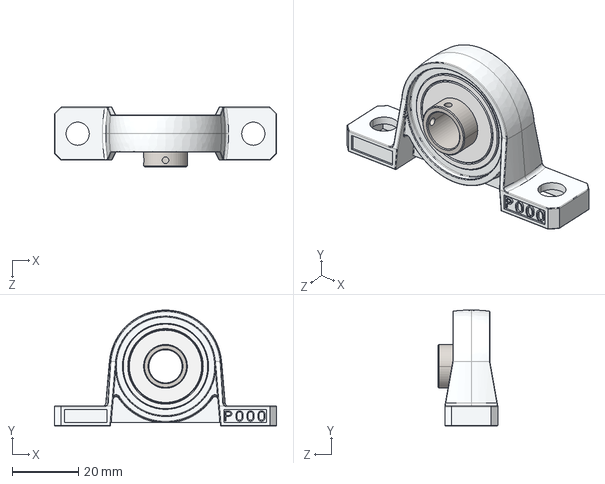
[picture p21: CAD file, 2025-02-14]
SolidWorks/KP-000 Bore 10mm Bearings Pillow.STEP
67.0 x 35.0 x 18.0 mm
