Ahmed-Samy-Elsaiid/Mechanical-Absorber/SolidWorks/frame legs.SLDPRT

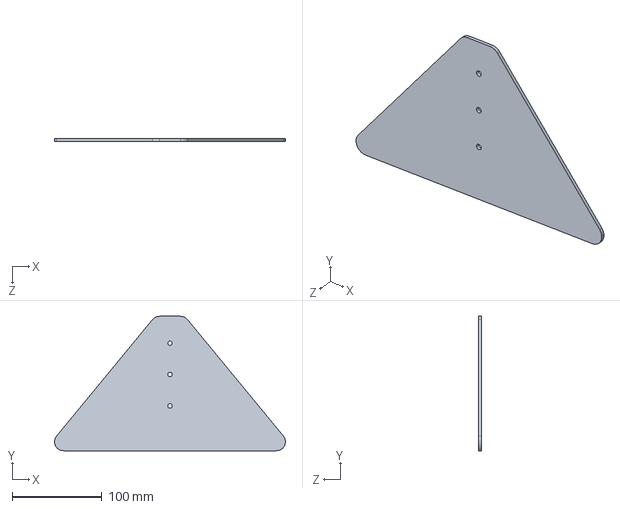
[picture p22: CAD file, 2025-02-14]
SolidWorks/frame legs.SLDPRT
257.6 x 150.0 x 3.00 mm
