Ahmed-Samy-Elsaiid/Mechanical-Absorber/(list of files, cad)

Other CAD files:
SolidWorks/KP-000 Bore 10mm Bearings Pillow O.SLDPRT
